davispolito/Retro-LFO/img/SCHERMATICV3.pdf

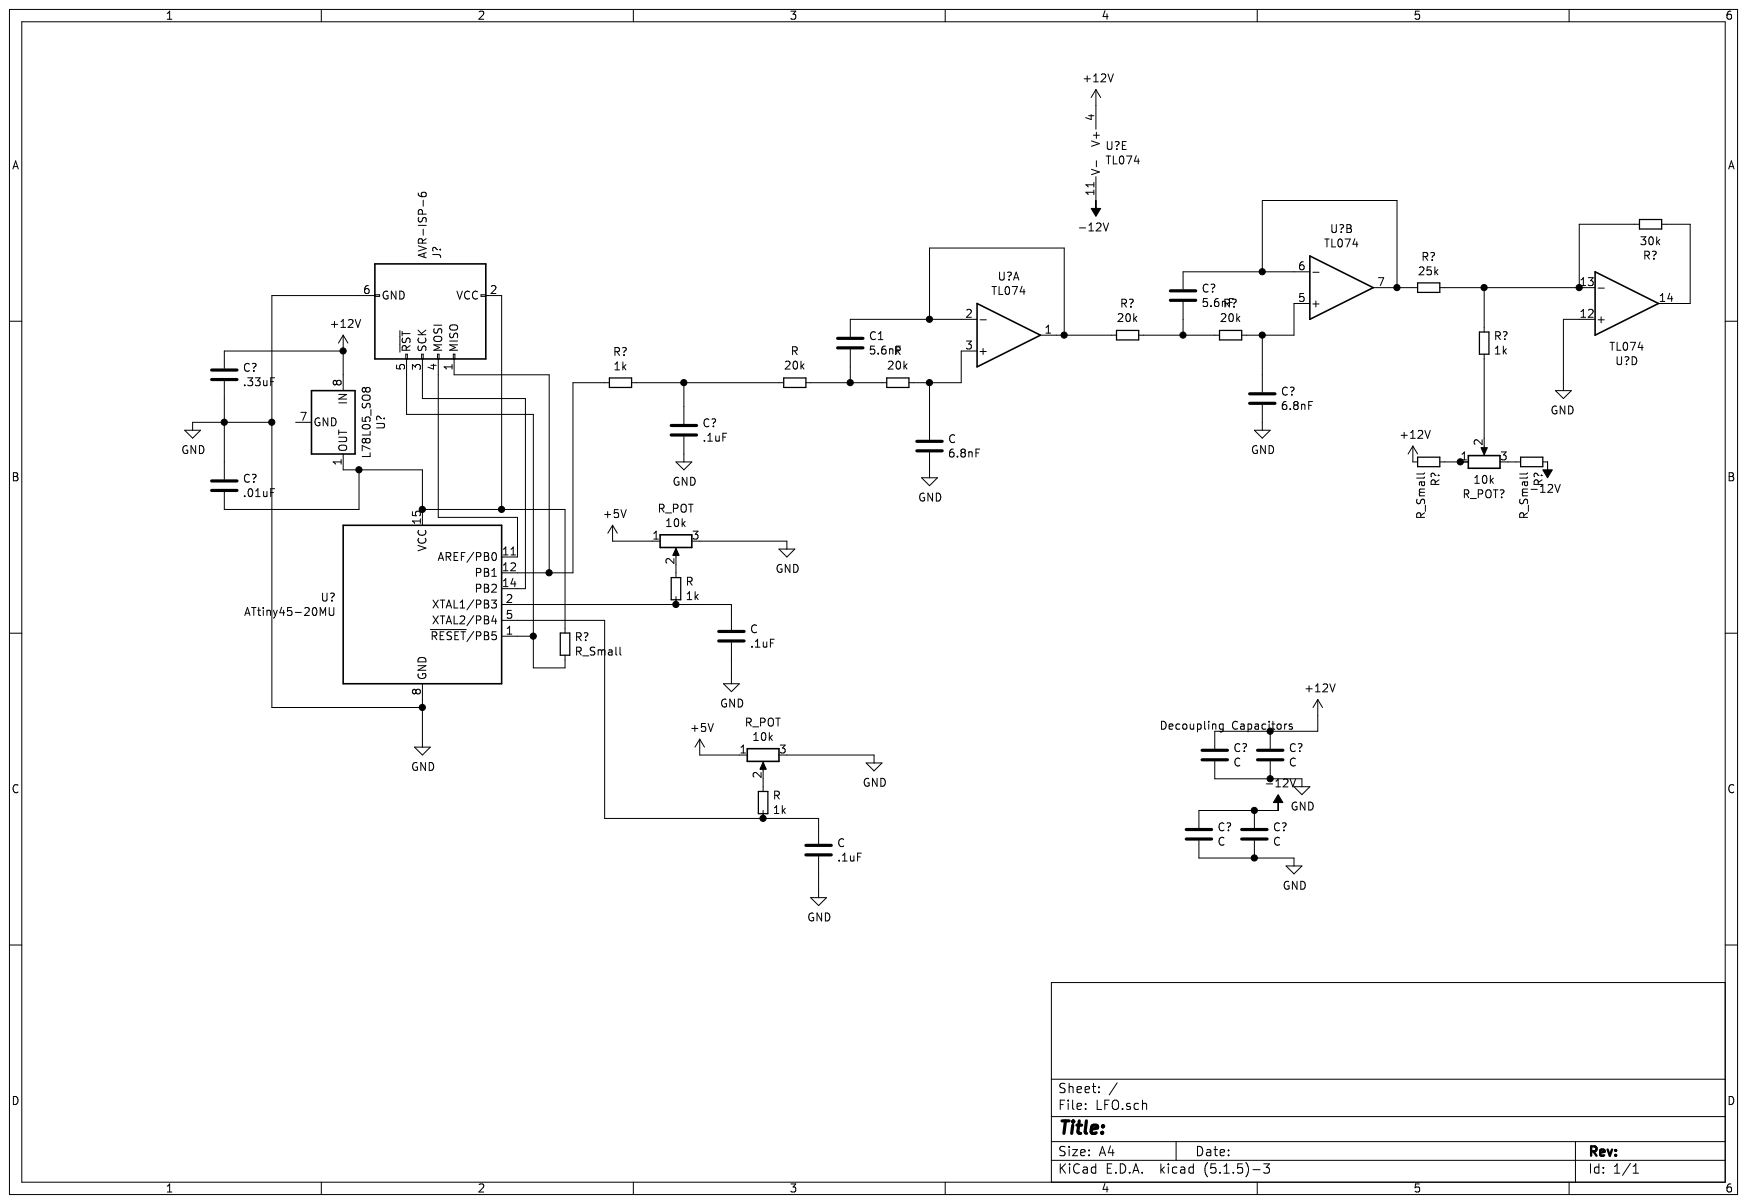
[picture p3: page 1]
