davispolito/Retro-LFO/LFO/LFO.kicad_pcb

## KiCad design LFO/LFO.kicad_pcb (2020-03-24)

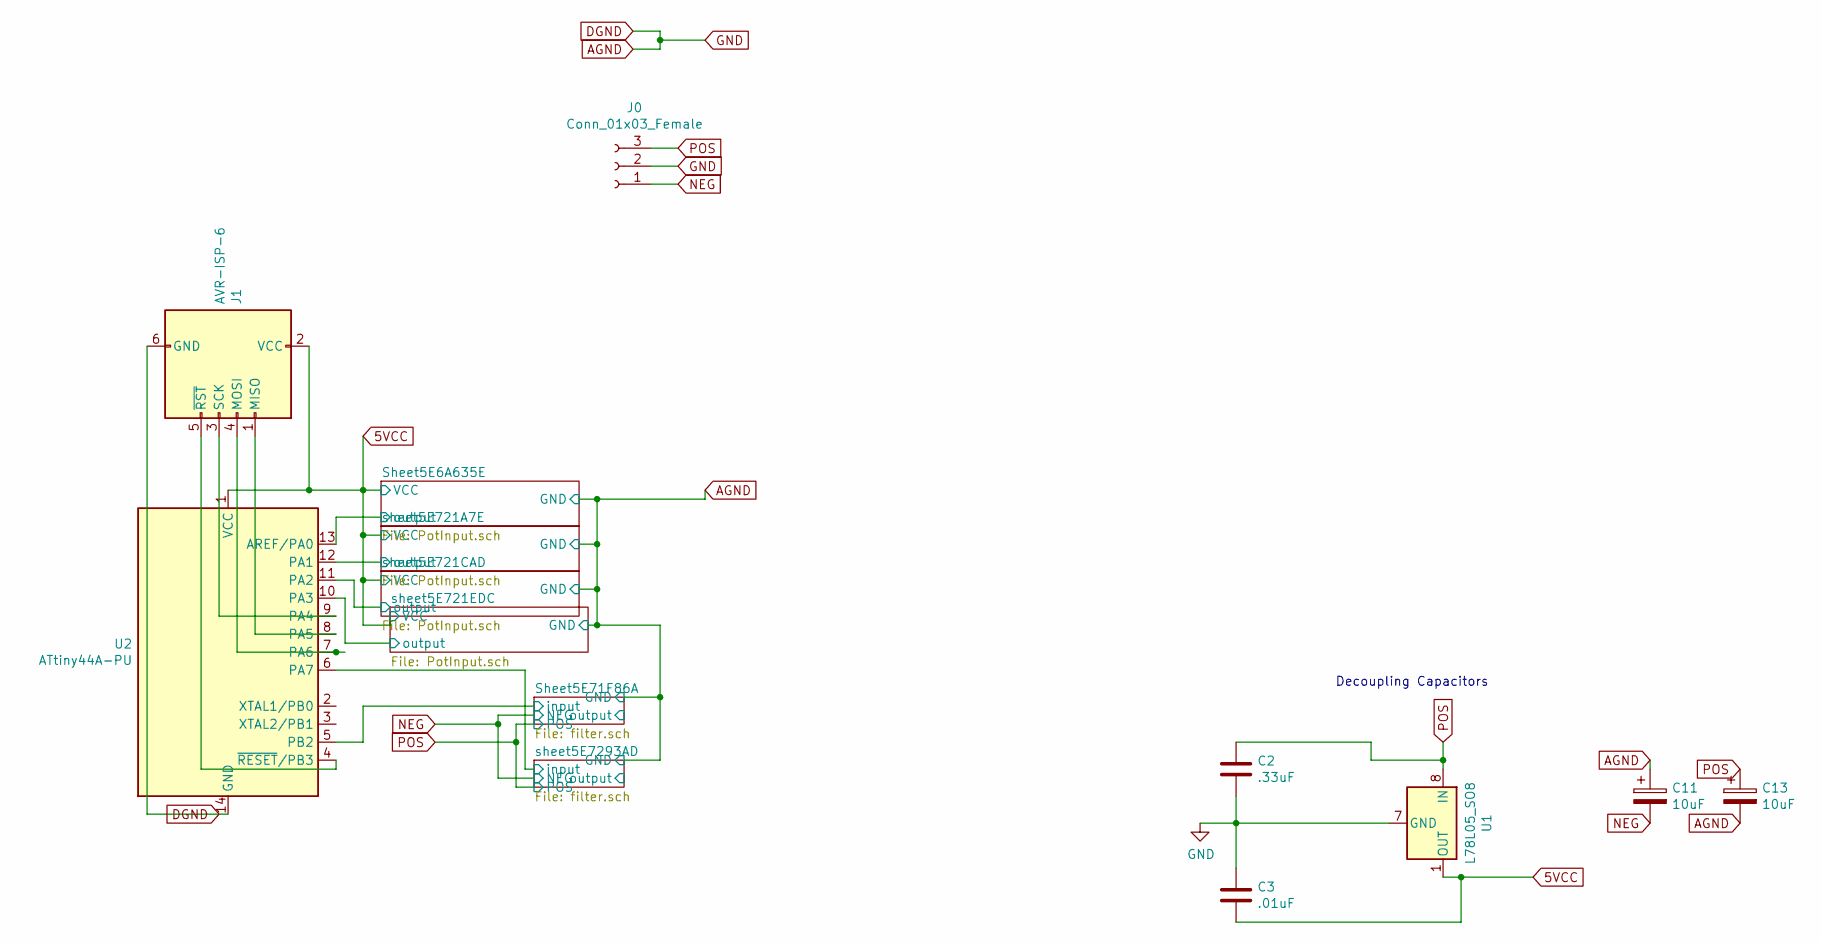
[picture p4: schematic LFO.sch]

Parts:
C2: .33uF; C_0603_1608Metric_Pad1.05x0.95mm_HandSolder
C3: .01uF; C_0201_0603Metric
C11, C13: 10uF; CP_EIA-3216-10_Kemet-I_Pad1.58x1.35mm_HandSolder
J0: Conn_01x03_Female; FanPinHeader_1x03_P2.54mm_Vertical
J1: AVR-ISP-6; Tag-Connect_TC2030-IDC-NL_2x03_P1.27mm_Vertical
U1: L78L05_SO8; SOIC-8_3.9x4.9mm_P1.27mm
U2: ATtiny44A-PU; SOIC-14_3.9x8.7mm_P1.27mm

Connections:
5VCC: C3.2, J1.2 (VCC), U1.1 (OUT), U2.1 (VCC); also elsewhere on the board
/Sheet5E6A635E/output: U2.13 (AREF/PA0); also elsewhere on the board
/Sheet5E71F86A/input: U2.5 (PB2); also elsewhere on the board
/sheet5E721A7E/output: U2.12 (PA1); also elsewhere on the board
/sheet5E721CAD/output: U2.11 (PA2); also elsewhere on the board
/sheet5E721EDC/output: U2.10 (PA3); also elsewhere on the board
/sheet5E7293AD/input: U2.6 (PA7); also elsewhere on the board
AGND: C2.2, C3.1, C11.1, C13.2, J0.2, J1.6 (GND), U1.2 (GND), U1.3 (GND), U1.6 (GND), U1.7 (GND), U2.14 (GND); also elsewhere on the board
NEG: C11.2, J0.1; also elsewhere on the board
unnamed: J1.1 (MISO), U2.8 (PA5)
unnamed: J1.3 (SCK), U2.9 (PA4)
unnamed: J1.4 (MOSI), U2.7 (PA6)
unnamed: J1.5 (~RST), U2.4 (~RESET~/PB3)
POS: C2.1, C13.1, J0.3, U1.8 (IN); also elsewhere on the board

Notes on the sheet:
Decoupling Capacitors

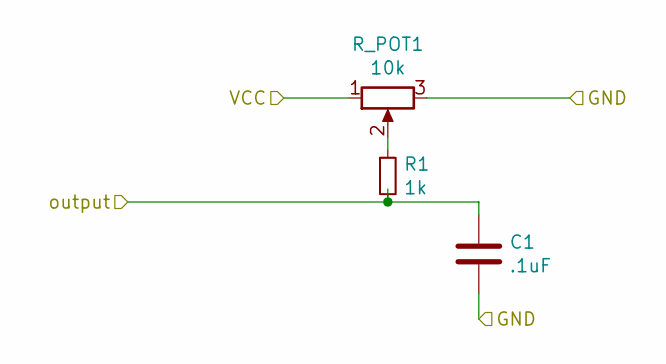
[picture p5: schematic PotInput.sch]

Parts:
C1: .1uF; C_0201_0603Metric
R1: 1k; R_0805_2012Metric_Pad1.15x1.40mm_HandSolder
R_POT1: 10k; FanPinHeader_1x03_P2.54mm_Vertical

Connections:
5VCC: R_POT1.1; also elsewhere on the board
/Sheet5E6A635E/output: C1.1, R1.2; also elsewhere on the board
AGND: C1.2, R_POT1.3; also elsewhere on the board
unnamed: R1.1, R_POT1.2

Parts of its further copies:
C9, C10, C12: .1uF; C_0201_0603Metric
R12, R13, R14: 1k; R_0805_2012Metric_Pad1.15x1.40mm_HandSolder
R_POT3, R_POT4, R_POT5: 10k; FanPinHeader_1x03_P2.54mm_Vertical

Connections of its further copies:
5VCC: R_POT3.1, R_POT4.1, R_POT5.1; also elsewhere on the board
/sheet5E721A7E/output: C9.1, R12.2; also elsewhere on the board
/sheet5E721CAD/output: C10.1, R13.2; also elsewhere on the board
/sheet5E721EDC/output: C12.1, R14.2; also elsewhere on the board
AGND: C9.2, C10.2, C12.2, R_POT3.3, R_POT4.3, R_POT5.3; also elsewhere on the board
unnamed: R12.1, R_POT3.2
unnamed: R13.1, R_POT4.2
unnamed: R14.1, R_POT5.2

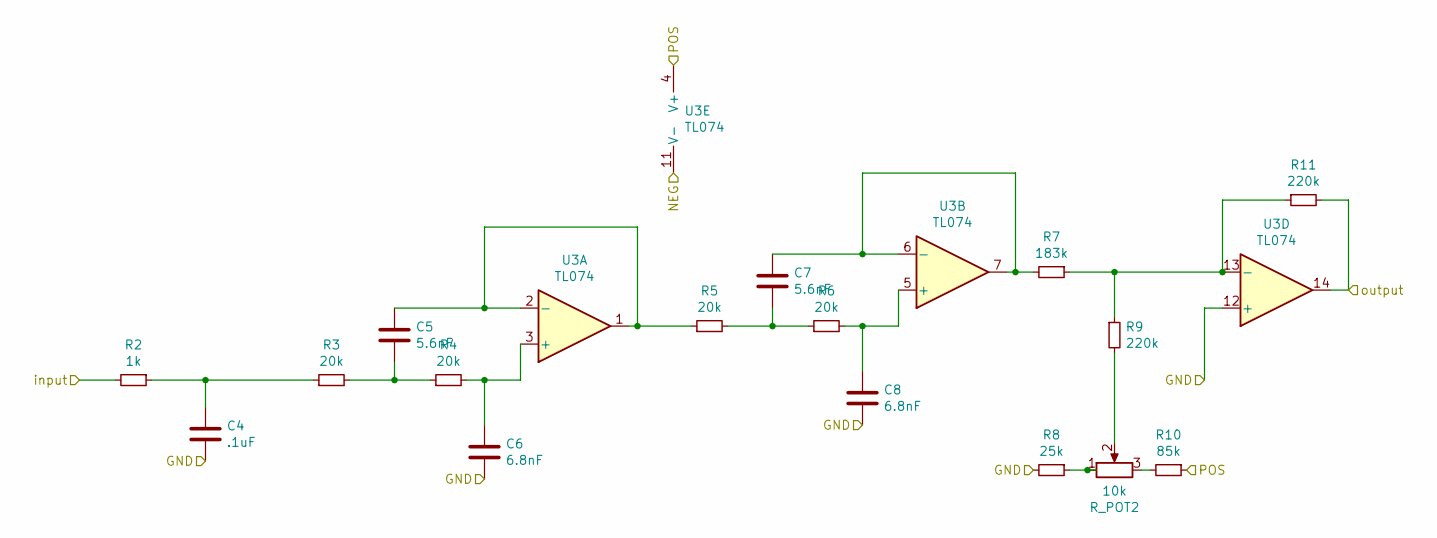
[picture p6: schematic filter.sch]

Parts:
C4: .1uF; C_0201_0603Metric
C5, C7: 5.6nF; C_0201_0603Metric
C6, C8: 6.8nF; C_0201_0603Metric
R2: 1k; R_0805_2012Metric_Pad1.15x1.40mm_HandSolder
R3, R4, R5, R6: 20k; R_0805_2012Metric_Pad1.15x1.40mm_HandSolder
R7: 183k; R_0805_2012Metric_Pad1.15x1.40mm_HandSolder
R8: 25k; R_0805_2012Metric_Pad1.15x1.40mm_HandSolder
R9, R11: 220k; R_0805_2012Metric_Pad1.15x1.40mm_HandSolder
R10: 85k; R_0805_2012Metric_Pad1.15x1.40mm_HandSolder
R_POT2: 10k; Potentiometer_Piher_PT-10-V10_Vertical_Hole
U3: TL074; SOIC-14_3.9x8.7mm_P1.27mm

Connections:
/Sheet5E71F86A/input: R2.2; also elsewhere on the board
/Sheet5E71F86A/output: R11.2, U3.14
AGND: C4.2, C6.2, C8.2, R8.2, U3.12 (+); also elsewhere on the board
NEG: U3.11 (V-); also elsewhere on the board
unnamed: C4.1, R2.1, R3.1
unnamed: C5.1, R5.1, U3.1, U3.2 (-)
unnamed: C5.2, R3.2, R4.1
unnamed: C6.1, R4.2, U3.3 (+)
unnamed: C7.1, R7.2, U3.6 (-), U3.7
unnamed: C7.2, R5.2, R6.1
unnamed: C8.1, R6.2, U3.5 (+)
unnamed: R8.1, R_POT2.1
unnamed: R9.2, R_POT2.2
unnamed: R10.2, R_POT2.3
unnamed: R7.1, R9.1, R11.1, U3.13 (-)
POS: R10.1, U3.4 (V+); also elsewhere on the board

Parts of its further copies:
C14: .1uF; C_0201_0603Metric
C15, C17: 5.6nF; C_0201_0603Metric
C16, C18: 6.8nF; C_0201_0603Metric
R15: 1k; R_0805_2012Metric_Pad1.15x1.40mm_HandSolder
R16, R17, R18, R19: 20k; R_0805_2012Metric_Pad1.15x1.40mm_HandSolder
R20: 183k; R_0805_2012Metric_Pad1.15x1.40mm_HandSolder
R21: 25k; R_0805_2012Metric_Pad1.15x1.40mm_HandSolder
R22, R24: 220k; R_0805_2012Metric_Pad1.15x1.40mm_HandSolder
R23: 85k; R_0805_2012Metric_Pad1.15x1.40mm_HandSolder
R_POT6: 10k; Potentiometer_Piher_PT-10-V10_Vertical_Hole
U4: TL074; SOIC-14_3.9x8.7mm_P1.27mm

Connections of its further copies:
/sheet5E7293AD/input: R15.2; also elsewhere on the board
/sheet5E7293AD/output: R24.2, U4.14
AGND: C14.2, C16.2, C18.2, R21.2, U4.12 (+); also elsewhere on the board
NEG: U4.11 (V-); also elsewhere on the board
unnamed: C14.1, R15.1, R16.1
unnamed: C15.1, R18.1, U4.1, U4.2 (-)
unnamed: C15.2, R16.2, R17.1
unnamed: C16.1, R17.2, U4.3 (+)
unnamed: C17.1, R20.2, U4.6 (-), U4.7
unnamed: C17.2, R18.2, R19.1
unnamed: C18.1, R19.2, U4.5 (+)
unnamed: R20.1, R22.1, R24.1, U4.13 (-)
unnamed: R21.1, R_POT6.1
unnamed: R22.2, R_POT6.2
unnamed: R23.2, R_POT6.3
POS: R23.1, U4.4 (V+); also elsewhere on the board

Board: 2 copper layers, 54 parts (0 on the bottom side), 42 nets, no tracks yet.
