davispolito/Retro-LFO/(commit log)

2019-11-27 Added Circuit Photograph
2020-01-08 Added Schematic
2020-01-08 Added png version of schematic
2020-01-14 Adding Schematic File
    [LFO.sch]
